tanakamanabu/divergence-meter/README.md

# Divergence Meter（ニキシー管時計）

Steins;Gate のダイバージェンスメーターを模した、ニキシー管 **IN-14 × 8桁** の時計プロジェクト。
マイコンに **Seeed Studio XIAO ESP32-C3** を使い、5V 電源から高電圧を昇圧してニキシー管を駆動する。

## 特徴 / 仕様

- **表示管**: IN-14 × 8桁（ダイバージェンスメーター風の見た目）
- **点灯方式**: ダイナミック点灯（1/4 多重化：2グループ×4スロット、74141×2）
- **マイコン**: Seeed Studio XIAO ESP32-C3（5V / USB Type-C 給電、WiFi で NTP 同期）
- **高電圧電源**: MC34063A + 結合インダクタ（1:10 フライバック）で 5V → 約 180V（外付け FET 不要）
- **給電**: モバイルバッテリー（USB 5V）で持ち運び可

## ハードウェア設計

回路設計・部品選定・KiCad プロジェクトの詳細は **[hardware/README.md](hardware/README.md)** にまとめている。

- 高圧電源（5V → 約 180V、MC34063A + 結合インダクタ 1:10 フライバック）
- 点灯ドライブ（1/4 多重化：74141×2 + アノード HV スイッチ×4 + ドット駆動）
- IN-14 のデータシート要点・ピンアサイン
- ライブラリ運用（自作 / third-party、[LIBRARIES.md](LIBRARIES.md)）

回路図入力の手順は [docs/schematic-guide.md](docs/schematic-guide.md) を参照。

## ロードマップ

- [x] 電源要件の整理（IN-14 データシート）
- [x] 5V → 180V 昇圧回路の設計（MC34063A + 1:10 フライバック）
- [x] 点灯ドライブ設計（1/4 多重化：74141×2 + アノード側ハイサイドSW×4）
- [x] ドット（LHDP/RHDP）駆動の追加設計
- [ ] 基板設計（桁配置・ドット割り当て）
- [ ] XIAO ESP32-C3 ファームウェア（時刻管理・ダイナミック点灯制御・NTP 同期など）
- [ ] 筐体設計

## ライセンス

[MIT License](LICENSE)
