tanakamanabu/divergence-meter/(commit log)

2026-06-21 Initial commit: IN-14 divergence meter project
    Add README with IN-14 datasheet summary, 5V->180V boost converter
    design, and project roadmap. Add MIT license.
2026-06-21 Add boost converter schematic
    Add docs/boost-converter.svg (MAX1771 5V->180V boost) and reference it
    from the README power-supply section.
2026-06-21 Finalize boost converter component values
    Set concrete values from MAX1771 datasheet (FB ref 1.5V, CS 100mV):
    R1=1.8M/R2=15k for ~181V, Rsense=0.1ohm for ~1A limit, and correct
    L to 47uH for 5V input. Update schematic and README with derivations.
2026-06-21 Add 1/4 multiplex lighting drive design
    Add drive-architecture.svg (74141x2 + 4 anode HV switches, 2 groups x
    4 slots) and anode-hv-switch.svg (MPSA92/MPSA42 high-side switch
    detail). Document drive scheme, GPIO budget, multiplex timing, level
    shift, and dot handling in README. Note mobile-battery (USB 5V) power.
2026-06-21 Add dot (LHDP/RHDP) driver design
    Add dot-driver.svg: high-voltage NPN (MPSA42) open-collector cathode
    driver with R_dot current limit, bussed per group L/R (LA/RA/LB/RB,
    4 lines) to time-multiplex all 16 dots. Update README dot section,
    GPIO budget (~15), and roadmap.
2026-06-21 Switch control to 74HCT595x2 shift registers
    Reduce MCU control lines from 15 to 3-4 via two daisy-chained
    74HCT595. Anode slot select now driven directly from 595 (one-hot),
    dropping the 74139. Add pin map and 16-bit allocation table, OE-PWM
    brightness note, and HCT level-shift rationale. Update architecture
    diagram accordingly.
2026-06-22 Scaffold KiCad hardware project structure
    Add project-local library layout (lib/custom.kicad_sym, custom.pretty,
    third-party) pre-registered via sym-lib-table/fp-lib-table, plus
    hardware/README, LIBRARIES.md sourcing notes, and third-party NOTICE.
    Extend .gitignore for KiCad temp files, *.kicad_prl, and .history.
    [divergence-meter.kicad_pcb, divergence-meter.kicad_sch]
2026-06-22 Switch MCU to XIAO ESP32-C3 with concrete pin map
    Select Seeed XIAO ESP32-C3 (cheap, USB-C, WiFi, U.FL antenna). Assign
    concrete GPIO: SPI MOSI/SCK to 595 SER/SRCLK, GPIO20 latch, GPIO21 OE
    PWM, I2C on D4/D5 for RTC, button on D3. Update README, architecture
    diagram, and LIBRARIES sourcing accordingly.
2026-06-22 Add schematic entry guide
    Add docs/schematic-guide.md: hierarchical sheet plan, entry order,
    net-naming convention, HV net class, IN-14 custom symbol pinout, and
    KiCad ERC/PWR_FLAG/footprint tips. Link from README roadmap.
2026-06-22 Add Seeed XIAO ESP32-C3 KiCad library (CC-BY-SA-4.0)
    Bundle Seeed OPL_Kicad_Library XIAO symbol + ESP32-C3 footprints under
    hardware/lib/third-party/Seeed_XIAO with upstream LICENSE. Register
    both in sym-/fp-lib-table (nickname Seeed_Studio_XIAO_Series so the
    symbol Footprint field resolves). Record attribution in NOTICE and
    mark bundled in LIBRARIES.
    License verified CC-BY-SA-4.0 (redistribution allowed with attribution).
2026-06-22 Update schematic guide to top-level sheet workflow
    Replace the hierarchical (nested) sheet plan with multiple top-level
    sheets connected by global labels, matching the global-label net
    naming. Document the KiCad 9/10 New Top Level Sheet steps and note
    copy-paste (vs reusable subsheet) for the repeated anode/dot blocks.
2026-06-22 Clarify power skeleton and PWR_FLAG placement in guide
    Document that power symbols are global (auto-connect across sheets),
    PWR_FLAG is one-per-net at the source (+5V/+180V/GND/+3V3), and the
    power skeleton lives on the power sheet (5V in, 180V out; 5V sourced
    from XIAO VBUS).
2026-06-22 Add custom +180V power symbol
    KiCad has no >12V rail symbol; add a project +180V power port to
    custom.kicad_sym (power pin named +180V so the net resolves correctly,
    unlike editing a +5V symbol value). For the HV nixie anode rail.
2026-06-22 Fix boost schematic for MAX1771 high-side current sense
    MAX1771 senses inductor current between V+ and CS, not in the MOSFET
    source. Move Rsense to the V+--CS path with the inductor on the CS
    side; tie MOSFET source straight to GND. Add REF 0.1uF bypass and
    SHDN-to-GND (active-high shutdown) per datasheet. Update README BOM,
    derivation note, and add MAX1771 pin-connection notes.
    Verified against datasheet (octopart excerpt) and msarnoff ChipDB.
    [divergence-meter.kicad_sch, power.kicad_sch]
2026-06-22 Fix dot-driver figure: pulldown taps base node, not R_b body
    R_pd previously branched from the middle of the R_b resistor body
    (misleading). Move the tap to the base node between R_b and the
    transistor, add junction dots.
2026-06-24 Fix HV power budget to match two-tube simultaneous lighting
    The drive design lights two tubes per slot (one each from group A/B via
    74141×2), but the power section still assumed a single tube lit at a time,
    underestimating HV current and power by ~2x. Update HV current (~5mA
    nominal, 10mA max), output power (1.8W), input current (~0.45A), and the
    Rsense rationale to be consistent with the two-tube spec.
2026-06-24 Add judge2005 nixie tube KiCad library (IN-series, IN-14 等)
    judge2005/Eagle-and-KiCAD-Nixie-Libs のレガシー Eagle/KiCad 形式を
    kicad-cli sym/fp upgrade で現行形式へ変換して同梱。
    nixies-us / mynixies / nixiemisc を sym-lib-table・fp-lib-table に登録。
    元リポジトリにライセンス表記が無いが、コミュニティで広く再利用され
    問題提起も見当たらないためメンテナ判断で同梱。経緯は NOTICE.md に記録。
2026-06-24 Fix nixie symbol footprint refs to lib:fp format
    変換後シンボルの Footprint 参照がレガシー形式（例 nixies-us_IN-14, コロン無し）
    のままで、KiCad が解決できず「不正なフットプリント」となり候補に出なかった。
    ライブラリ名:フットプリント名 形式（Nixie_judge2005_nixies-us:nixies-us-IN-14 等）
    へ一括修正し、nixies-us / mynixies / nixiemisc 全シンボルで解決可能に。
2026-06-25 docs: 高圧電源を MC34063A 構成に更新しドキュメントを再編
    - ルート README をプロジェクト概要に整理し、ハードウェア詳細は
    hardware/README.md に集約（電源・点灯ドライブ・IN-14 データシート等）
    - 高圧電源（5V→180V 昇圧）を MAX1771 から MC34063A 構成へ更新
    （基準 1.25V / Rsc 0.3Ω / Ct 追加、FB 分圧 R2 を再計算）
    - docs/schematic-guide.md の部品・ライブラリ記述を MC34063A に更新
    - docs/boost-converter.svg を MC34063A 版に描き直し
2026-06-25 chore: KiCad 自動生成レポートを .gitignore に追加
    ERC/DRC レポート（*.rpt）とアノテーション/基板更新の
    メッセージ出力（report.txt）を追跡対象から除外する。
2026-06-25 docs: 高圧電源を MC34063A フライバック（1:10）構成に更新
    USB 5V のまま 180V を得るため、単段ブースト＋外付け FET から
    結合インダクタ（巻数比 1:10）によるフライバックへ変更。
    - スイッチ OFF 時の一次電圧 ≈ 23V に収まり MC34063A の内蔵スイッチ
    (40V) をそのまま一次スイッチに使用 → 外付け FET 不要・5V ゲート駆動問題が解消
    - 結合インダクタ T1 = Coilcraft LPR6235-253（1:10 / 一次25µH / Isat 1.3A）
    - 漏れスパイク対策に一次側 RCD スナバ（Dsn/Rsn/Csn）を追加
    - 回路図 SVG をフライバック構成に描き直し、全8ピン結線・データシ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
2026-06-25 docs: フライバックのスナバを RCD からツェナークランプに変更
    スコープでの追い込みが不要な確定方式にするため、一次側の保護を
    RCD スナバ（Dsn/Rsn/Csn）から ツェナークランプ（Dsn + DZ 27〜30V）へ変更。
    - スイッチノード→Vin に Dsn(高速)＋DZ を直列、ピーク = 5+Vz < 40V を確定
    - 漏れインダクタ値に依存せず Vz でクランプ電圧が決まる（実測調整不要）
    - 回路図 SVG のスナバ部を Dsn＋ツェナー記号に描き直し
    - README・schematic-guide の該当記述を更新
